Richard-CRT/BMW-F20-AHU-CAN-Relay/PCB/Output/Renders/front.png

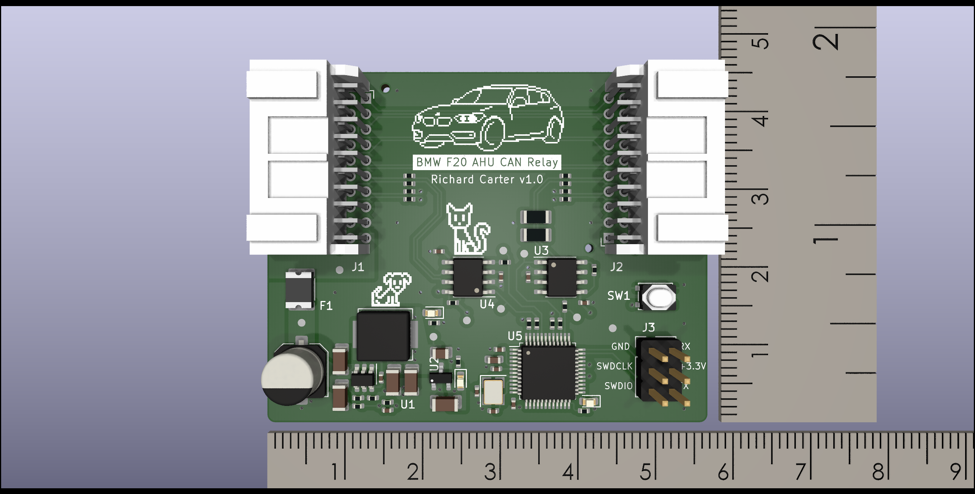
PCB/Output/Renders/front.png
