Richard-CRT/BMW-F20-AHU-CAN-Relay/PCB/Output/Renders/angle.png

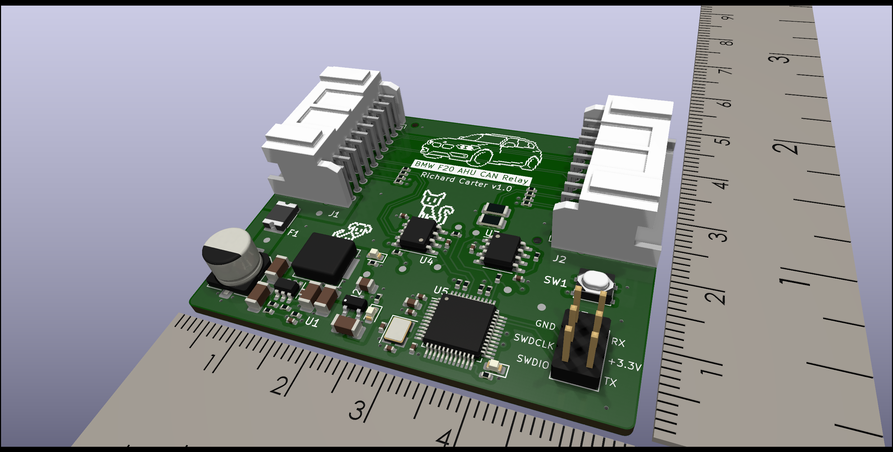
PCB/Output/Renders/angle.png
