Richard-CRT/BMW-F20-AHU-CAN-Relay/Cables/PADP-20V-1-S.png

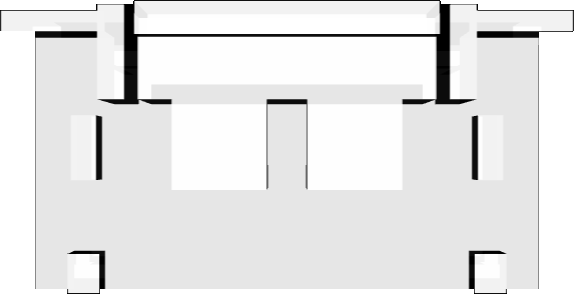
Cables/PADP-20V-1-S.png
