Richard-CRT/BMW-F20-AHU-CAN-Relay/Cables/PADP-20V-1-S.step

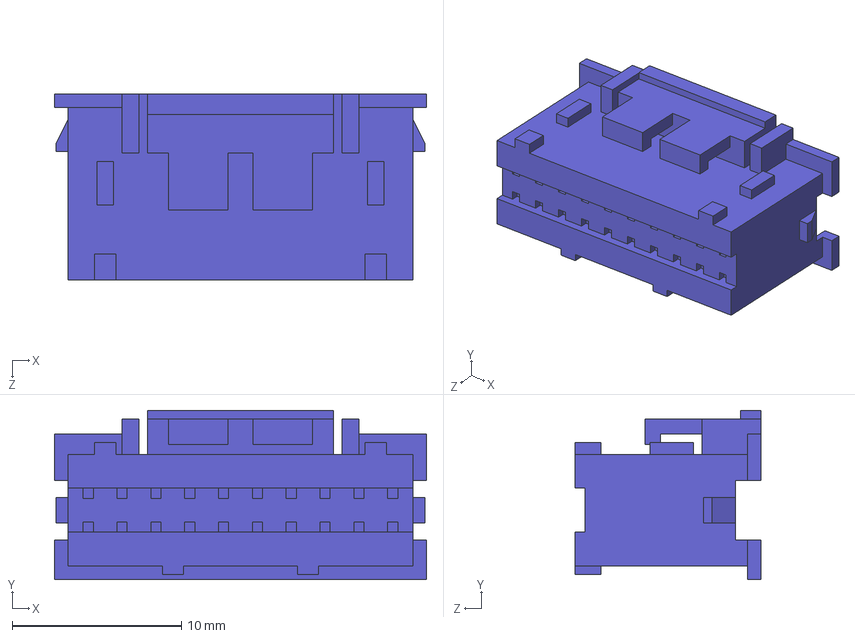
[picture p5: CAD file, 2023-04-01]
Cables/PADP-20V-1-S.step
22.0 x 10.00 x 11.0 mm
