Richard-CRT/BMW-F20-AHU-CAN-Relay/PCB/Output/Schematics/main.pdf

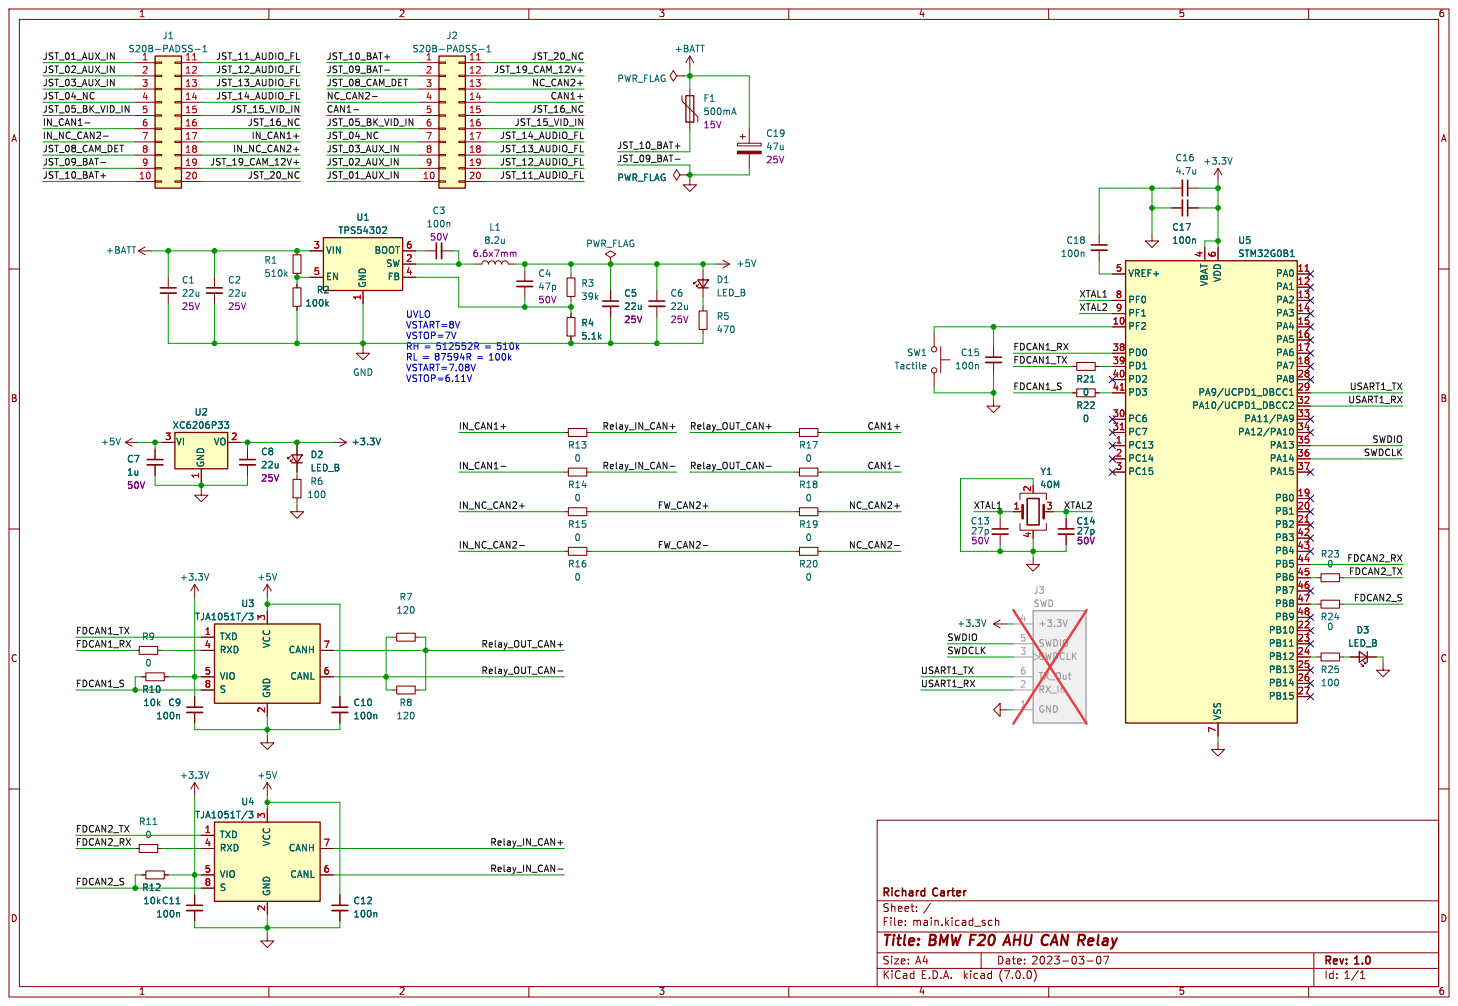
[picture p7: page 1]

1 SW 2 VIN 3 FB 4 EN 5 BOOT 6 U1 TPS54302 PWR_FLAG

1 SW 2 VIN 3 FB 4 EN 5 BOOT 6 R2

VSTART=8V
VSTOP=7V RH = 512552R = 510k RL = 87594R = 100k VSTART=7.08V

3 RXD 4 VIO 5 CANL 6 CANH 7 S

Id: 1/1 Title: BMW F20 AHU CAN Relay
