Richard-CRT/BMW-F20-AHU-CAN-Relay/PCB/main.kicad_pcb

## KiCad design PCB/main.kicad_pcb (2023-04-04)

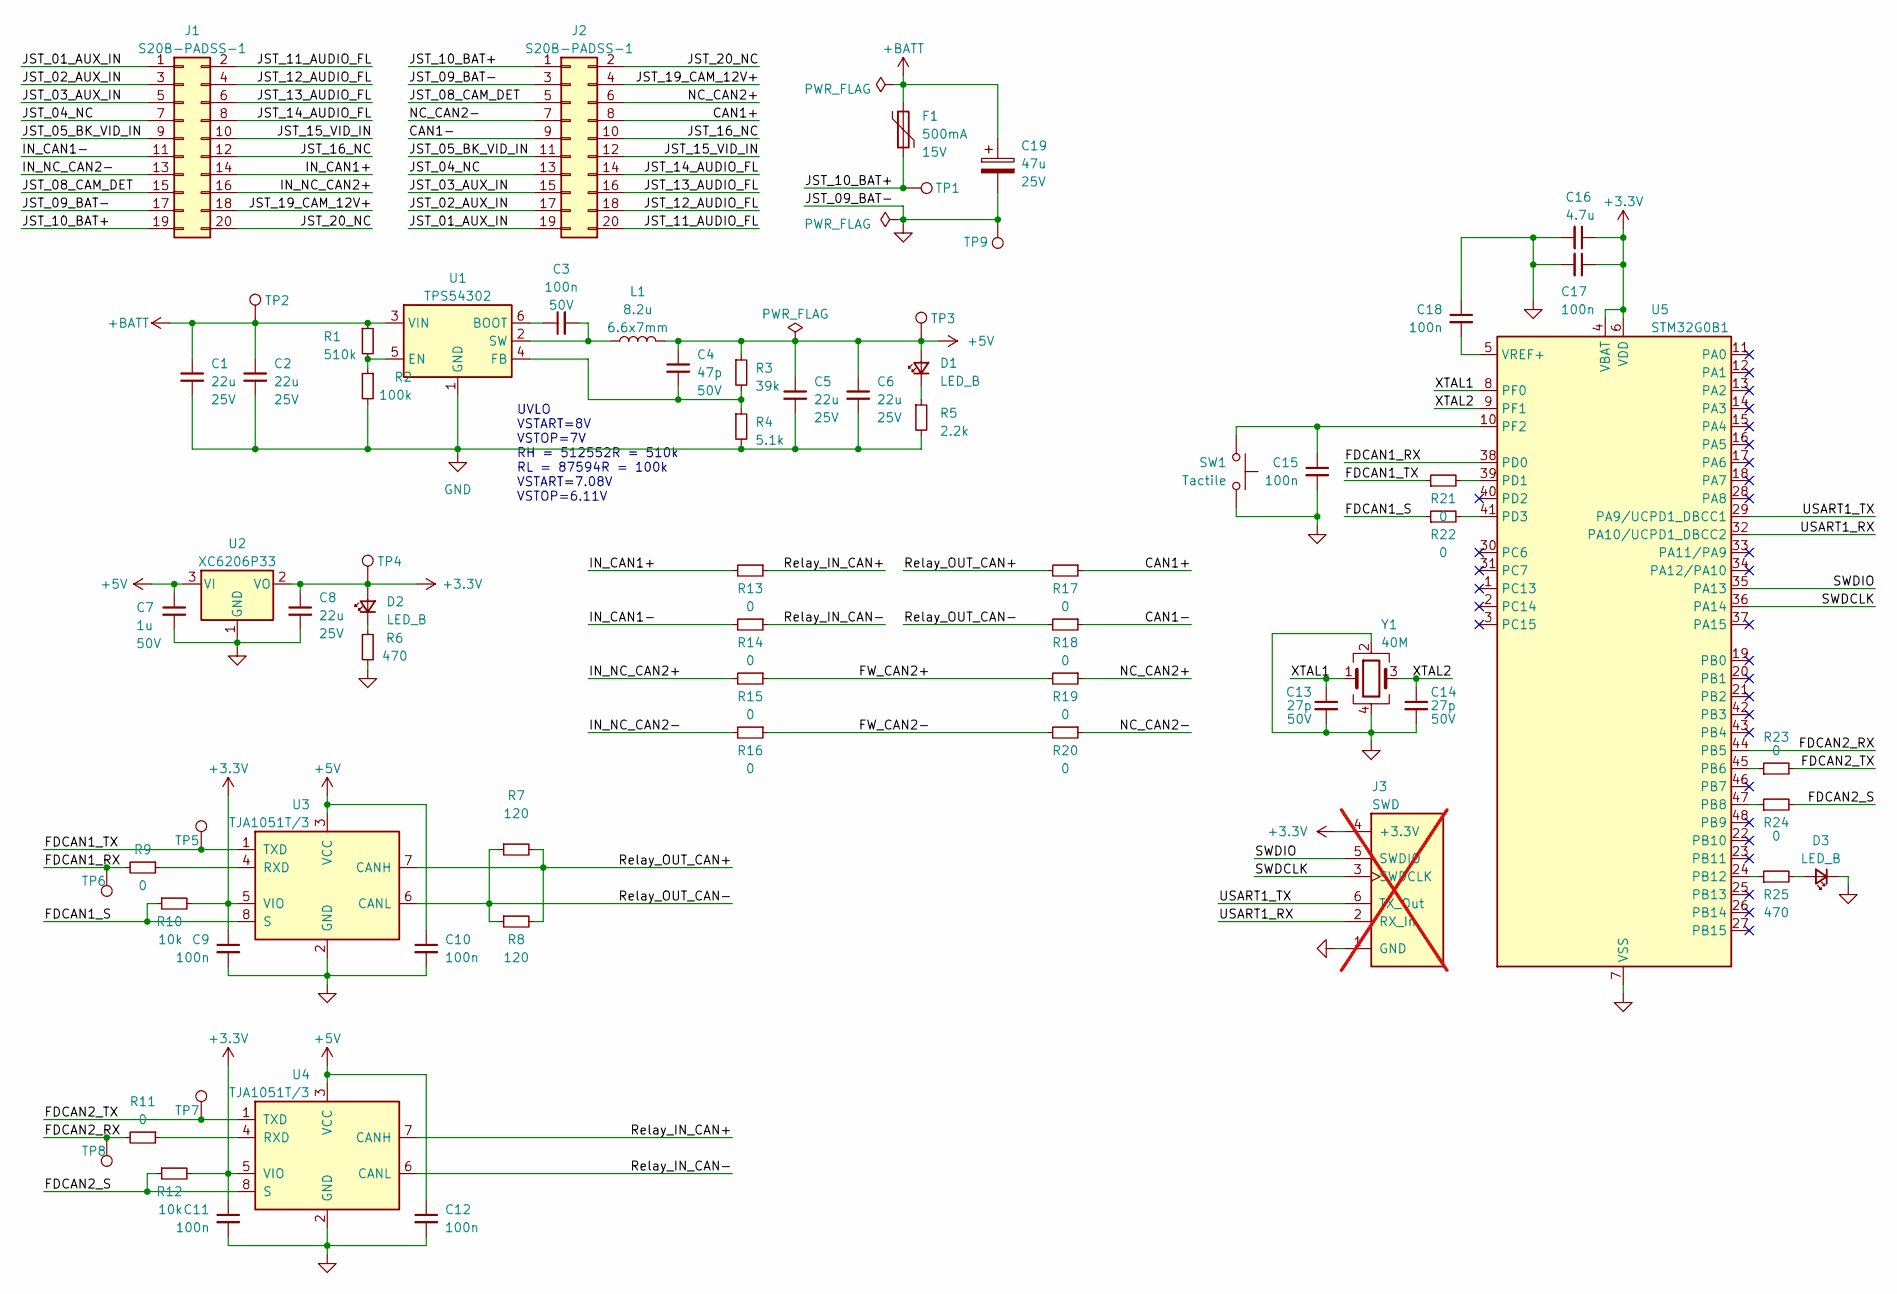
[picture p8: schematic main.kicad_sch, BMW F20 AHU CAN Relay]

Parts:
C1, C2, C5, C6, C8: 22u; C_1206_3216Metric; Capacitance Tolerance 10%; Voltage Rating 25V; MPN CL31A226KAHNNNE; LCSC C12891
C3, C9, C10, C11, C12, C15, C17, C18: 100n; C_0402_1005Metric; Capacitance Tolerance 10%; Voltage Rating 50V; MPN CL05B104KB54PNC; LCSC C307331
C4: 47p; C_0402_1005Metric; Capacitance Tolerance 5%; Voltage Rating 50V; MPN 0402CG470J500NT; LCSC C1567
C7: 1u; C_0805_2012Metric; Capacitance Tolerance 10%; Voltage Rating 50V; MPN CL21B105KBFNNNE; LCSC C28323
C13, C14: 27p; C_0402_1005Metric; Capacitance Tolerance 5%; Voltage Rating 50V; MPN 0402CG270J500NT; LCSC C1557
C16: 4.7u; C_0603_1608Metric; Capacitance Tolerance 10%; Voltage Rating 16V; MPN CL10A475KO8NNNC; LCSC C19666
C19: 47u; CP_Elec_6.3x5.8; Capacitance Tolerance 20%; Voltage Rating 25V; MPN EEE-FK1E470P; LCSC C178545
D1, D2, D3: LED_B; LED_0603_1608Metric; Forward Voltage 2.8V; MPN 19-217/BHC-ZL1M2RY/3T; LCSC C72041
F1: 500mA; CMP-0076; Max Voltage 15V; MPN 1812L050PR; LCSC C151169
J1, J2: S20B-PADSS-1; CMP-0012; MPN S20B-PADSS-1
J3: SWD; CMP-0053; not fitted
L1: 8.2u; CMP-0058; Inductance Tolerance 20%; MPN FXL0630-8R2-M; LCSC C167222
R1: 510k; R_0402_1005Metric; Tolerance 1%; Power Rating 62.5mW; MPN 0402WGF5103TCE; LCSC C11616
R2: 100k; R_0402_1005Metric; Tolerance 1%; Power Rating 62.5mW; MPN 0402WGF1003TCE; LCSC C25741
R3: 39k; R_0402_1005Metric; Tolerance 1%; Power Rating 62.5mW; MPN 0402WGF3902TCE; LCSC C25783
R4: 5.1k; R_0402_1005Metric; Tolerance 1%; Power Rating 62.5mW; MPN 0402WGF5101TCE; LCSC C25905
R5: 2.2k; R_0402_1005Metric; Tolerance 1%; Power Rating 62.5mW; MPN 0402WGF2201TCE; LCSC C25879
R6, R25: 470; R_0402_1005Metric; Tolerance 1%; Power Rating 62.5mW; MPN 0402WGF4700TCE; LCSC C25117
R7, R8: 120; R_1206_3216Metric; Tolerance 1%; Power Rating 250mW; MPN RC1206FR-07120RL; LCSC C114928
R9, R11, R13, R14, R15, R16, R17, R18, R19, R20, R21, R22, R23, R24: 0; R_0402_1005Metric; Tolerance 1%; Power Rating 62.5mW; MPN 0402WGF0000TCE; LCSC C17168
R10, R12: 10k; R_0402_1005Metric; Tolerance 1%; Power Rating 62.5mW; MPN 0402WGF1002TCE; LCSC C25744
SW1: Tactile; CMP-0072; MPN PTS810SJK250SMTRLFS; LCSC C221896
TP1, TP2, TP3, TP4, TP5, TP6, TP7, TP8, TP9: TestPoint; TestPoint_Pad_D1.0mm
U1: TPS54302; SOT-23-6; MPN TPS54302DDCR; LCSC C311983
U2: XC6206P33; CMP-0019; MPN XC6206P332MR-G; LCSC C5446
U3, U4: TJA1051T/3; SOIC-8_3.9x4.9mm_P1.27mm; MPN TJA1051T/3/1J; LCSC C38695
U5: STM32G0B1; LQFP-48_7x7mm_P0.5mm; MPN STM32G0B1CBT6; LCSC C2847904
Y1: 40M; Crystal_SMD_3225-4Pin_3.2x2.5mm; Tolerance 15 PPM; MPN X322540MPB4SI; LCSC C9010

Connections:
+3.3V: C8.1, C9.1, C11.1, C16.1, C17.1, D2.2 (A), J3.4 (+3.3V), R10.2, R12.2, TP4.1, U2.2 (VO), U3.5 (VIO), U4.5 (VIO), U5.4 (VBAT), U5.6 (VDD)
+5V: C4.1, C5.1, C6.1, C7.1, C10.1, C12.1, D1.2 (A), L1.2, R3.1, TP3.1, U2.3 (VI), U3.3 (VCC), U4.3 (VCC)
+BATT: C1.1, C2.1, C19.1, F1.1, R1.1, TP2.1, U1.3 (VIN)
/CAN1+: J2.8, R17.1
/CAN1-: J2.9, R18.1
/FDCAN1_RX: R9.2, TP6.1, U5.38 (PD0)
/FDCAN1_S: R10.1, R22.1, U3.8 (S)
/FDCAN1_TX: R21.1, TP5.1, U3.1 (TXD)
/FDCAN2_RX: R11.2, TP8.1, U5.44 (PB5)
/FDCAN2_S: R12.1, R24.2, U4.8 (S)
/FDCAN2_TX: R23.2, TP7.1, U4.1 (TXD)
/FW_CAN2+: R15.1, R19.2
/FW_CAN2-: R16.1, R20.2
/IN_CAN1+: J1.14, R13.2
/IN_CAN1-: J1.11, R14.2
/IN_NC_CAN2+: J1.16, R15.2
/IN_NC_CAN2-: J1.13, R16.2
/JST_01_AUX_IN: J1.1, J2.19
/JST_02_AUX_IN: J1.3, J2.17
/JST_03_AUX_IN: J1.5, J2.15
/JST_04_NC: J1.7, J2.13
/JST_05_BK_VID_IN: J1.9, J2.11
/JST_08_CAM_DET: J1.15, J2.5
/JST_10_BAT+: F1.2, J1.19, J2.1, TP1.1
/JST_11_AUDIO_FL: J1.2, J2.20
/JST_12_AUDIO_FL: J1.4, J2.18
/JST_13_AUDIO_FL: J1.6, J2.16
/JST_14_AUDIO_FL: J1.8, J2.14
/JST_15_VID_IN: J1.10, J2.12
/JST_16_NC: J1.12, J2.10
/JST_19_CAM_12V+: J1.18, J2.4
/JST_20_NC: J1.20, J2.2
/NC_CAN2+: J2.6, R19.1
/NC_CAN2-: J2.7, R20.1
/Relay_IN_CAN+: R13.1, U4.7 (CANH)
/Relay_IN_CAN-: R14.1, U4.6 (CANL)
/Relay_OUT_CAN+: R7.2, R8.2, R17.2, U3.7 (CANH)
/Relay_OUT_CAN-: R7.1, R8.1, R18.2, U3.6 (CANL)
/SWDCLK: J3.3 (SWDCLK), U5.36 (PA14)
/SWDIO: J3.5 (SWDIO), U5.35 (PA13)
/USART1_RX: J3.2 (RX_In), U5.32 (PA10/UCPD1_DBCC2)
/USART1_TX: J3.6 (TX_Out), U5.29 (PA9/UCPD1_DBCC1)
/XTAL1: C13.1, U5.8 (PF0), Y1.1
/XTAL2: C14.1, U5.9 (PF1), Y1.3
unnamed: D1.1 (K), R5.1
unnamed: D2.1 (K), R6.2
unnamed: D3.2 (A), R25.2
unnamed: C3.1, U1.6 (BOOT)
unnamed: R1.2, R2.1, U1.5 (EN)
unnamed: C4.2, R3.2, R4.1, U1.4 (FB)
unnamed: C3.2, L1.1, U1.2 (SW)
unnamed: R9.1, U3.4 (RXD)
unnamed: R11.1, U4.4 (RXD)
unnamed: R23.1, U5.45 (PB6)
unnamed: R24.1, U5.47 (PB8)
unnamed: R25.1, U5.24 (PB12)
unnamed: R21.2, U5.39 (PD1)
unnamed: R22.2, U5.41 (PD3)
unnamed: C15.1, SW1.1, U5.10 (PF2)
unnamed: C18.2, U5.5 (VREF+)

Notes on the sheet:
UVLO VSTART=8V VSTOP=7V RH = 512552R = 510k RL = 87594R = 100k VSTART=7.08V VSTOP=6.11V

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
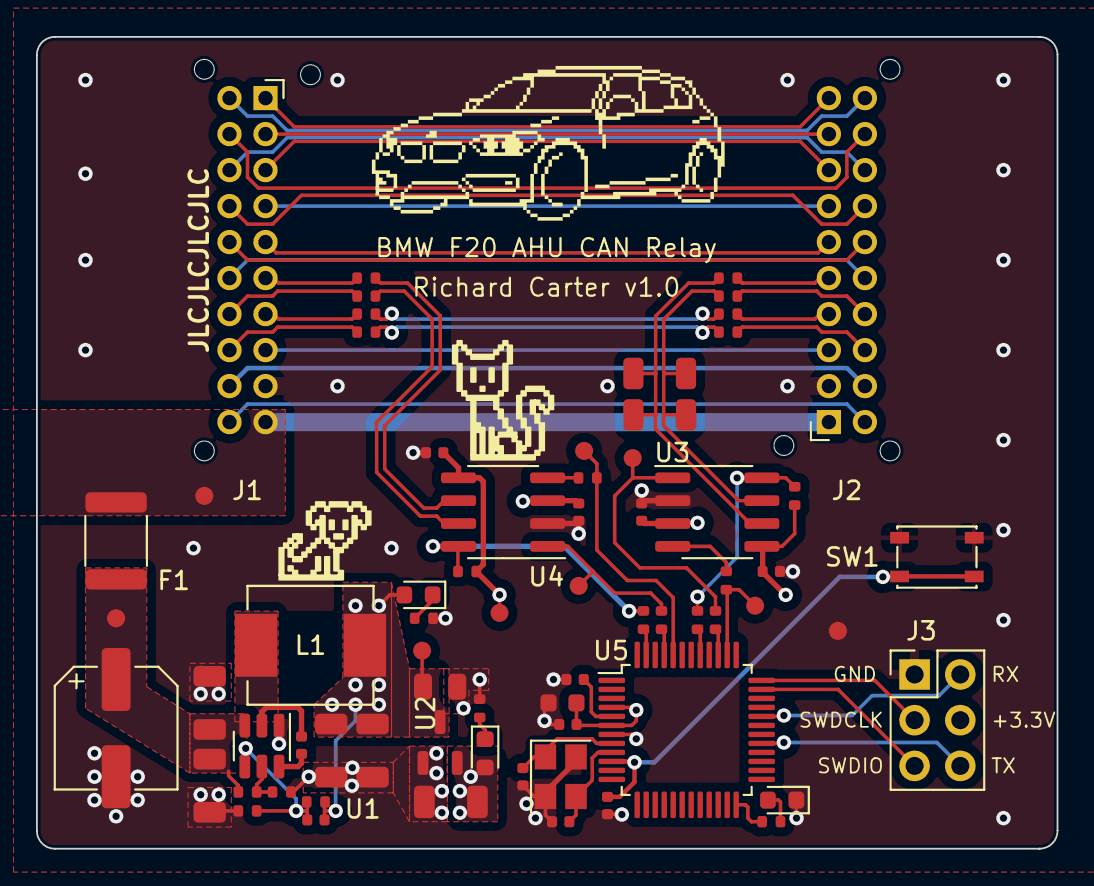
[picture p9: board main.kicad_pcb from above]

Board: 4 copper layers, 56.7 x 45.1 mm, 69 parts (0 on the bottom side), 61 nets.

Other parts of the board:
ART3: JLCJLCJLCJLC; CMP-0047
