Richard-CRT/BMW-F20-AHU-CAN-Relay/Firmware/app/app.ioc

Mcu.UserName=STM32G0B1CBTx
PA10.Signal=USART1_RX
PA13.Signal=SYS_SWDIO
PA14-BOOT0.Signal=SYS_SWCLK
PA9.Signal=USART1_TX
PB12.GPIO_Label=LED
PB12.Signal=GPIO_Output
PB5.Signal=FDCAN2_RX
PB6.Signal=FDCAN2_TX
PB8.GPIO_Label=FDCAN2_S
PB8.Signal=GPIO_Output
PD0.Signal=FDCAN1_RX
PD1.Signal=FDCAN1_TX
PD3.GPIO_Label=FDCAN1_S
PD3.Signal=GPIO_Output
