Richard-CRT/BMW-F20-AHU-CAN-Relay/Firmware/app/Core/Inc/main.h

#define LED_Pin GPIO_PIN_12
#define LED_GPIO_Port GPIOB
#define FDCAN1_S_Pin GPIO_PIN_3
#define FDCAN1_S_GPIO_Port GPIOD
#define FDCAN2_S_Pin GPIO_PIN_8
#define FDCAN2_S_GPIO_Port GPIOB
