Richard-CRT/BMW-F20-AHU-CAN-Relay/Firmware/test_app/Core/Src/main.c

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
/* Includes ------------------------------------------------------------------*/
#include "main.h"

/* USER CODE BEGIN PD */

#define FLAGS_ADDRESS (FLASH_BASE + (30 * 0x400))

/* USER CODE END PD */

TIM_HandleTypeDef htim3;

UART_HandleTypeDef huart1;

void SystemClock_Config(void);
static void MX_GPIO_Init(void);
static void MX_TIM3_Init(void);
static void MX_USART1_UART_Init(void);
/* USER CODE BEGIN 0 */

uint8_t tenths_of_seconds = 0;

void HAL_TIM_PeriodElapsedCallback(TIM_HandleTypeDef *htim)
{
	if (htim->Instance == TIM3)
		HAL_GPIO_TogglePin(LED_GPIO_Port, LED_Pin);
	else
		HAL_GPIO_TogglePin(LED_GPIO_Port, LED_Pin);
}

HAL_StatusTypeDef flag_bootloader()
{
	HAL_FLASH_Unlock();
	FLASH_EraseInitTypeDef EraseInitStruct;
	EraseInitStruct.TypeErase = FLASH_TYPEERASE_PAGES;
	EraseInitStruct.Banks = FLASH_BANK_1;

	uint32_t page = (FLAGS_ADDRESS - FLASH_BASE) / (2 * 0x400);

	EraseInitStruct.Page = page;
	EraseInitStruct.NbPages = 1;

	uint32_t PageError;
	if (HAL_FLASHEx_Erase(&EraseInitStruct, &PageError) != HAL_OK) //Erase the Page Before a Write Operation
		return HAL_ERROR;

	HAL_Delay(50);
	HAL_FLASH_Program(FLASH_TYPEPROGRAM_DOUBLEWORD, FLAGS_ADDRESS, 1);
	HAL_Delay(50);
	HAL_FLASH_Lock();

	return HAL_OK;
}

/* USER CODE END 0 */

/**
  * @brief  The application entry point.
  * @retval int
  */
int main(void)
{
  /* MCU Configuration--------------------------------------------------------*/

  /* Reset of all peripherals, Initializes the Flash interface and the Systick. */
  HAL_Init();

  /* Configure the system clock */
  SystemClock_Config();

  /* Initialize all configured peripherals */
  MX_GPIO_Init();
  MX_TIM3_Init();
  MX_USART1_UART_Init();
  /* USER CODE BEGIN 2 */

  HAL_TIM_Base_Start_IT(&htim3);

  /* USER CODE END 2 */

  /* Infinite loop */
  /* USER CODE BEGIN WHILE */
	while (1)
	{
		uint8_t data;
		HAL_UART_Receive(&huart1, &data, 1, 1000);
		HAL_UART_Transmit(&huart1, &data, 1, 1000);
		if (data == 'r')
		{
			flag_bootloader();
			NVIC_SystemReset();
		}

    /* USER CODE END WHILE */

    /* USER CODE BEGIN 3 */
	}
  /* USER CODE END 3 */
}

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
