Richard-CRT/BMW-F20-AHU-CAN-Relay/(commit log)

2023-03-01 Create PCB project
    [main.kicad_pcb, main.kicad_sch]
2023-03-01 General design
    [main.kicad_sch]
2023-03-04 Develop schematic a little and create initial software project
    [main.kicad_sch]
2023-03-04 Develop board
    [main.kicad_pcb, main.kicad_sch]
2023-03-05 Further develop board
    [main.kicad_pcb, main.kicad_sch]
2023-03-05 Finish schematic
    [main.kicad_pcb, main.kicad_sch]
2023-03-05 Add blinky LED
2023-03-05 Switch Silent mode on by default
    [main.kicad_pcb, main.kicad_sch]
2023-03-06 Add fuse holder
    [main.kicad_pcb, main.kicad_sch]
2023-03-07 Change buck converter
    [main.kicad_pcb, main.kicad_sch]
2023-03-07 Continue development
    [main.kicad_pcb, main.kicad_sch]
2023-03-07 Add JLCJLCJLCJLC placeholder artwork
    [main.kicad_sch]
2023-03-08 Start layout, but intend to ditch the 0ohm resistors and be confident CAN1 is the right one (remember 0402 links)
    [main.kicad_pcb, main.kicad_sch]
2023-03-08 Start relayout
    [main.kicad_pcb, main.kicad_sch]
2023-03-08 Add UART and mostly complete layout
    [main.kicad_pcb, main.kicad_sch]
2023-03-09 Tweak proj settings
    [main.kicad_pcb]
2023-03-10 Remove / from case/package
    [main.kicad_pcb, main.kicad_sch]
2023-03-11 Switch to multi library parts system
    [main.kicad_pcb, main.kicad_sch]
2023-03-11 Start moving to TPS54302
    [main.kicad_pcb, main.kicad_sch]
2023-03-11 Re-layout with TPS54302
    [main.kicad_pcb, main.kicad_sch]
2023-03-12 Start changing LDO
    [main.kicad_pcb, main.kicad_sch]
2023-03-12 Further development, started final GND pour
    [main.kicad_pcb, main.kicad_sch]
2023-03-12 Finish plane layout
    [main.kicad_pcb]
2023-03-12 Generate gerbers
    [main-B_Cu.gbl, main-B_Mask.gbs, main-B_Paste.gbp, main-B_Silkscreen.gbo, main-Edge_Cuts.gm1, main-F_Cu.gtl, main-F_Mask.gts, main-F_Paste.gtp]
2023-03-12 Switch to TJA1051T/3
    [main-BOM.csv, main.kicad_pcb, main.kicad_sch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]
2023-03-13 Added bulk capacitance
    [main-BOM.csv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]
2023-03-13 Generate output files
    [main-BOM.csv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]
2023-03-13 Change switch
    [main.kicad_pcb, main.kicad_sch]
2023-03-13 Redo layout to support use of B20B-PADSS due to stock inavailability
    [main-BOM.csv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]
2023-03-13 Add boss hole incase I need to use B20B-PADSS-1F
    [main-B_Cu.gbl, main-B_Mask.gbs, main-B_Paste.gbp, main-B_Silkscreen.gbo, main-Edge_Cuts.gm1, main-F_Cu.gtl, main-F_Mask.gts, main-F_Paste.gtp]
2023-03-14 Plot schematic
2023-03-14 Change fuse and adjust board size
    [main-BOM.csv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]
2023-03-14 Update car graphic
    [main.kicad_pcb]
2023-03-31 Improve thermal relief
    [main.kicad_pcb]
2023-04-01 Finish cable drawing pending length confirmation
    [PADP-20V-1-S.step]
2023-04-01 Fix typo for wire bom ID in elec wiring diagram
2023-04-01 Reduce LED brightness
    [main.kicad_pcb, main.kicad_sch]
2023-04-02 Continue development of firmware, interrupt UART setup
2023-04-04 Update drawing with revised pin numbering scheme
2023-04-04 Make some improvements including bringing the lost test points back
    [main.kicad_pcb, main.kicad_sch]
2023-04-04 Change fuse model
    [main.kicad_pcb]
2023-04-04 Adjust board colours and generate renders
    [main.kicad_pcb]
2023-04-07 Significant work on CANBUS code
2023-04-15 Switch to properly defined FSM
2023-04-15 Potentially fix turn off bug
    [can_controller_t.cpp, can_controller_t.h, can_controllers.h, fifo_buf_t.cpp, main.c, uart_controller_t.cpp, uart_controller_t.h]
2023-04-15 Remove old func prototype
2023-04-22 Fix period of timer
    [main.c]
2023-04-23 Restructure significantly, attempt to fix bug by disabling auto error retransmission on AHU side, add bootloader that doesn't do anything yet
    [app.ioc, app_main.cpp, app_main.h, bl_main.cpp, bl_main.h, bootloader.ioc, can_controller_t.cpp, can_controller_t.h]
2023-05-10 Fix print lengths and comment unused code
    [bl_main.cpp]
