Richard-CRT/BMW-F20-AHU-CAN-Relay/(notices)

Notices in the files:
Firmware/test_app/Core/Src/main.c:
Copyright (c) 2023 STMicroelectronics.
All rights reserved.
This software is licensed under terms that can be found in the LICENSE file
